Stachu1/Sodar/pictures/sodar_setup.png

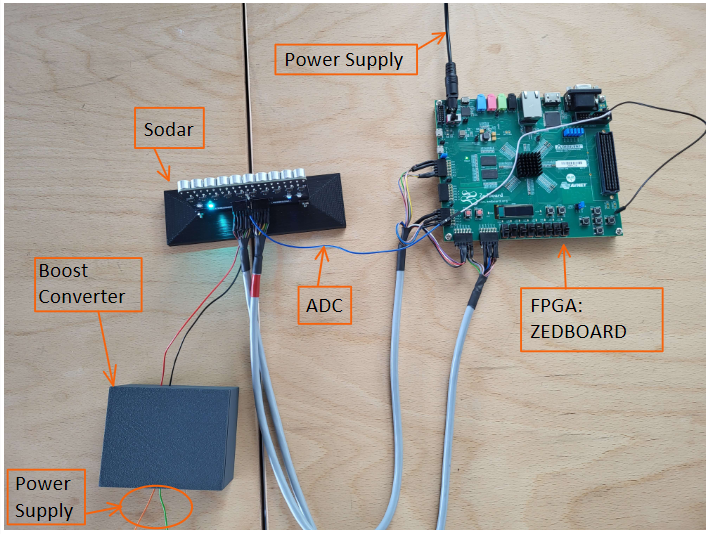
pictures/sodar_setup.png
