Stachu1/Sodar/simulations/pattern_3D.png

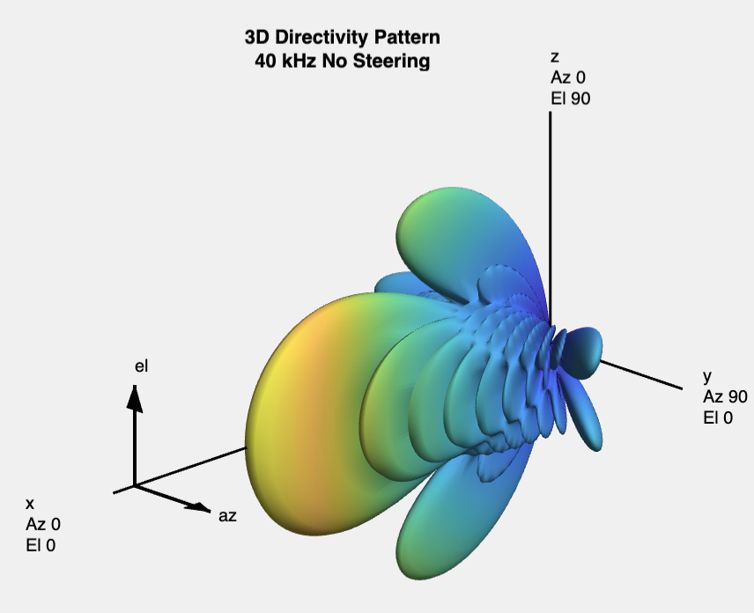
simulations/pattern_3D.png
