Stachu1/Sodar/pictures/Flow_chart_sodar.PNG

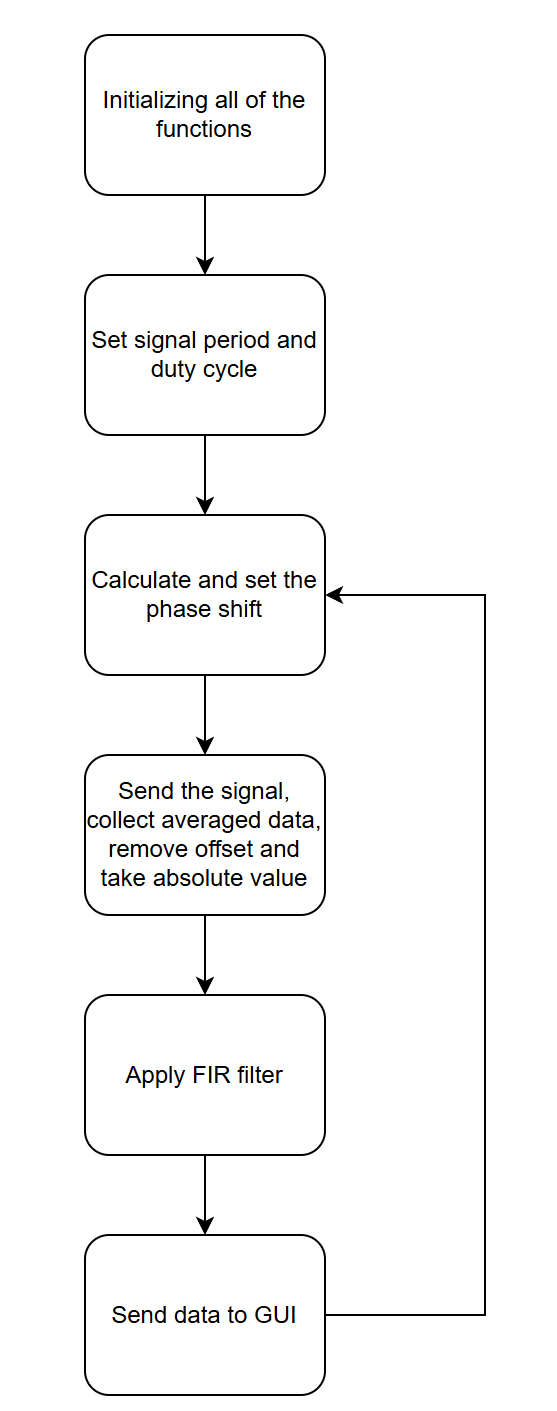
pictures/Flow_chart_sodar.PNG
