Stachu1/Sodar/pictures/PCB.png

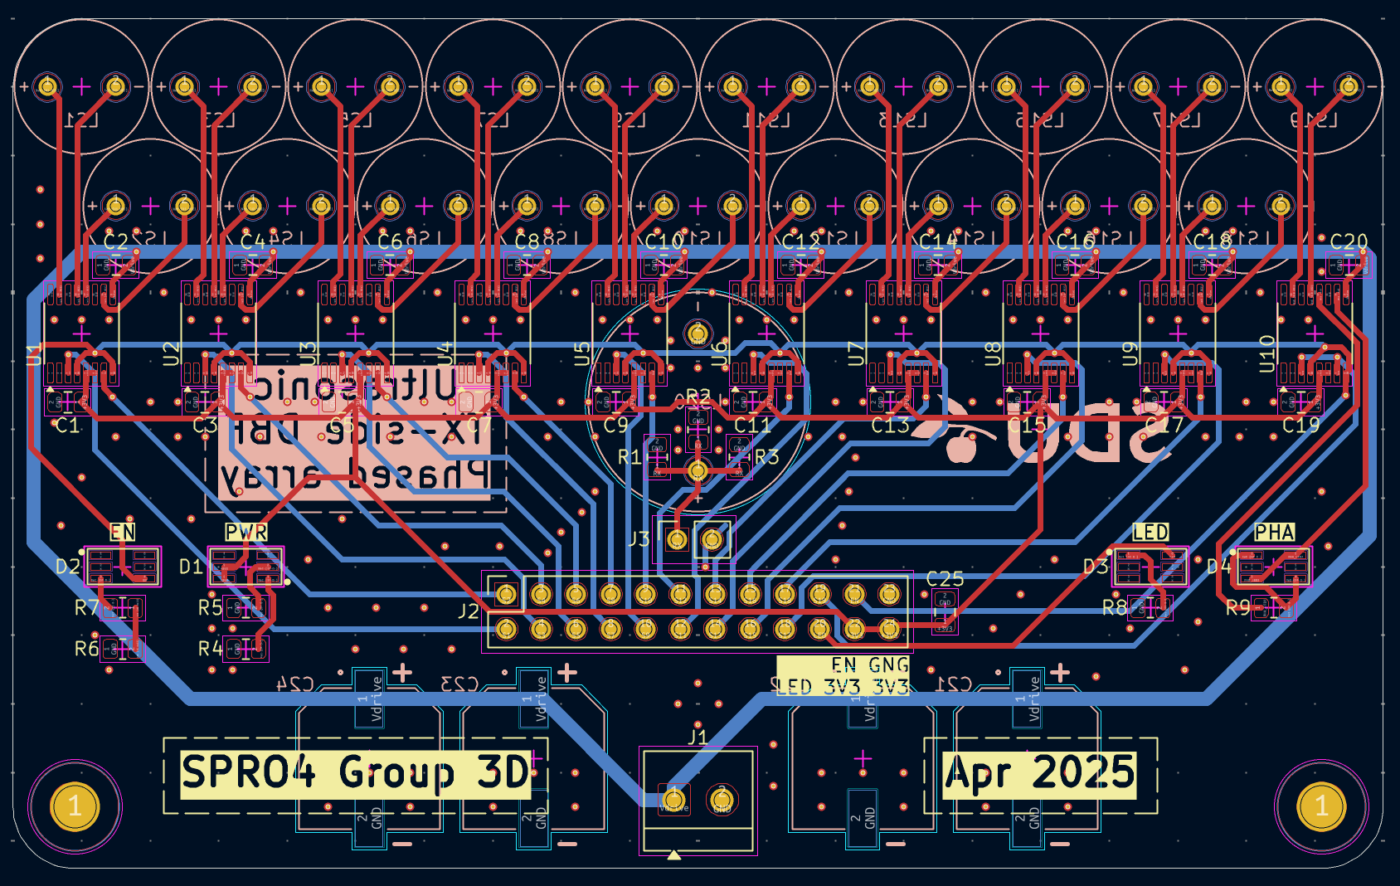
pictures/PCB.png
