Stachu1/Sodar/pictures/PCB_Sodar_schematic.PNG

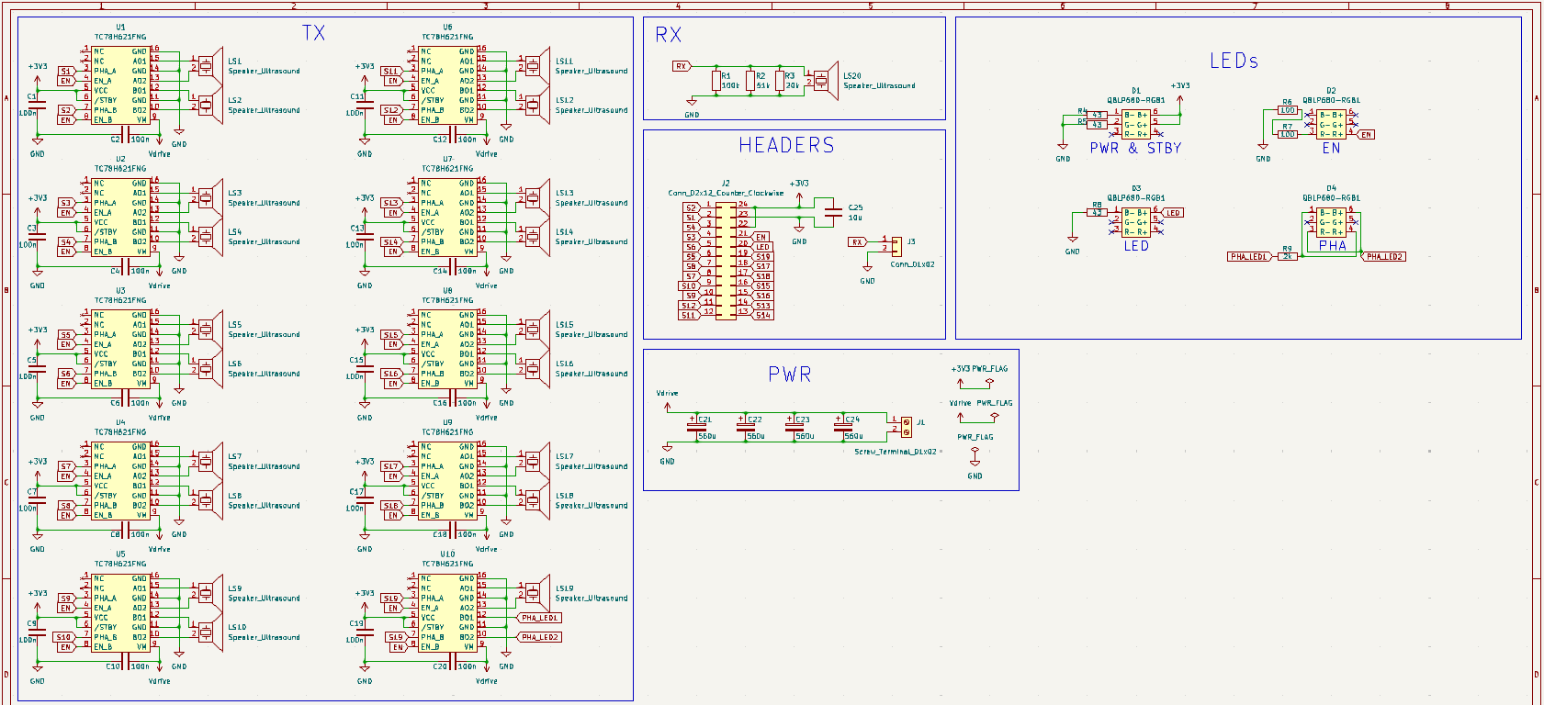
pictures/PCB_Sodar_schematic.PNG
