Stachu1/Sodar/pictures/Scan_distance.png

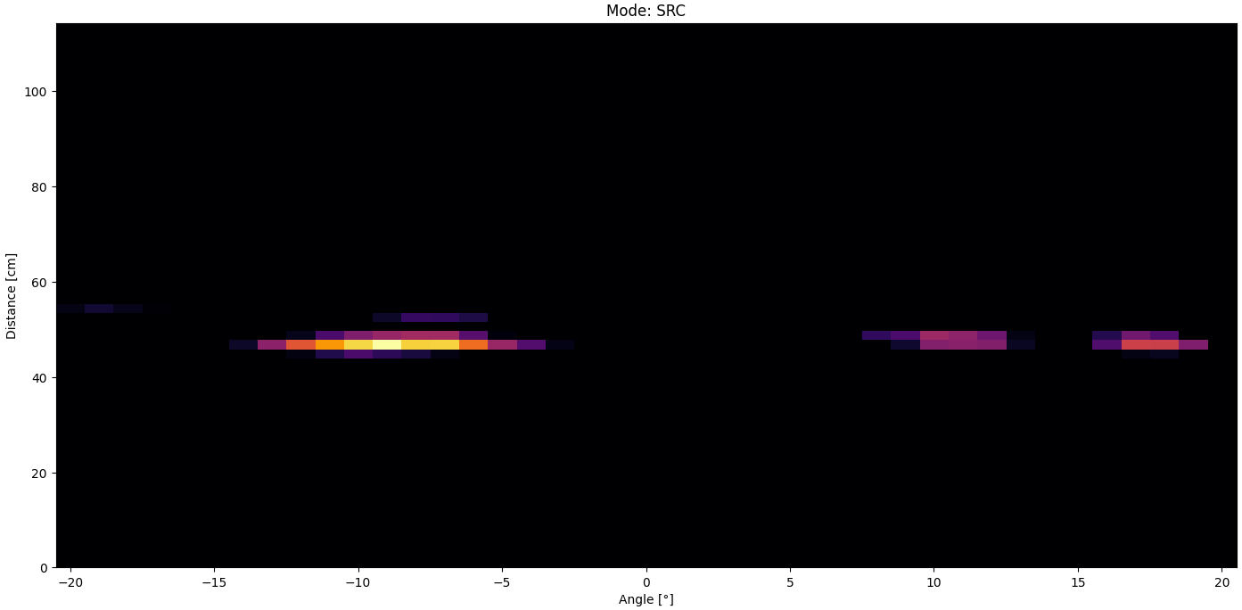
pictures/Scan_distance.png
