Stachu1/Sodar/pictures/Scan_early.png

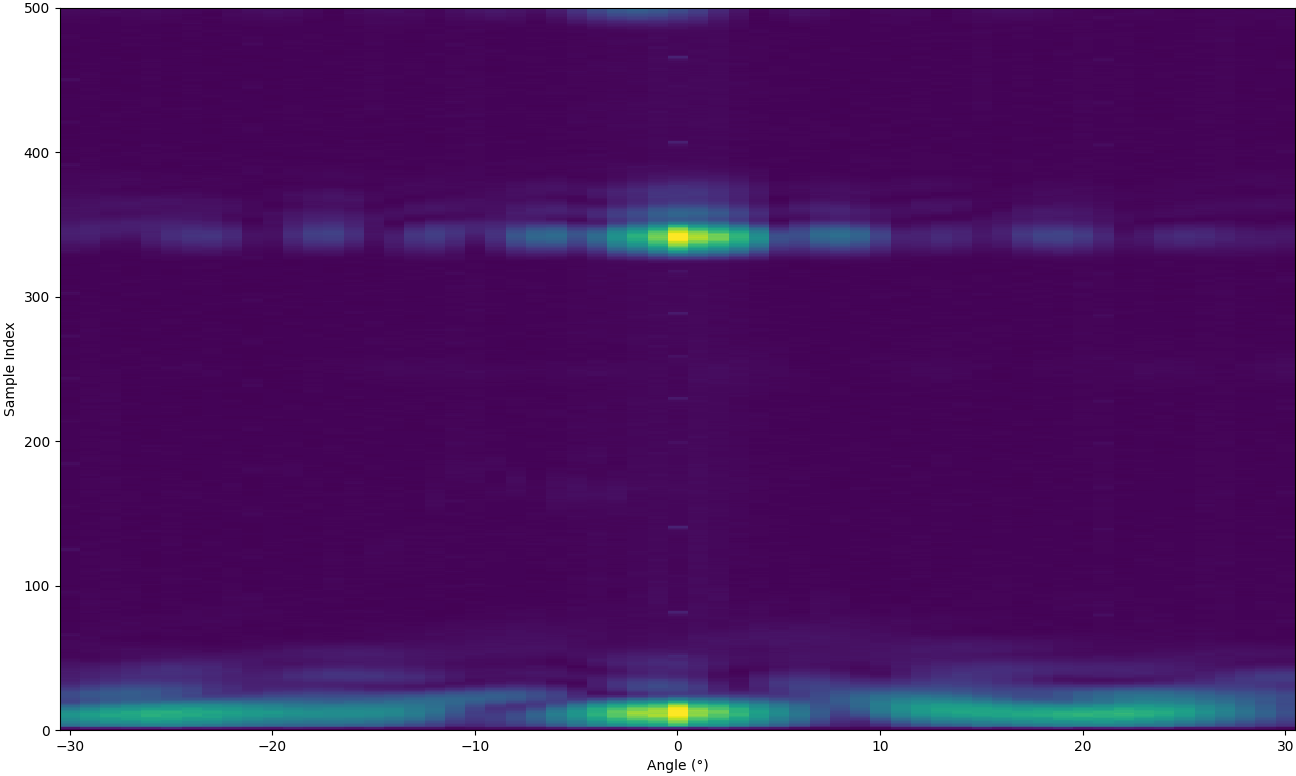
pictures/Scan_early.png
