Stachu1/Sodar/pictures/system_overview.png

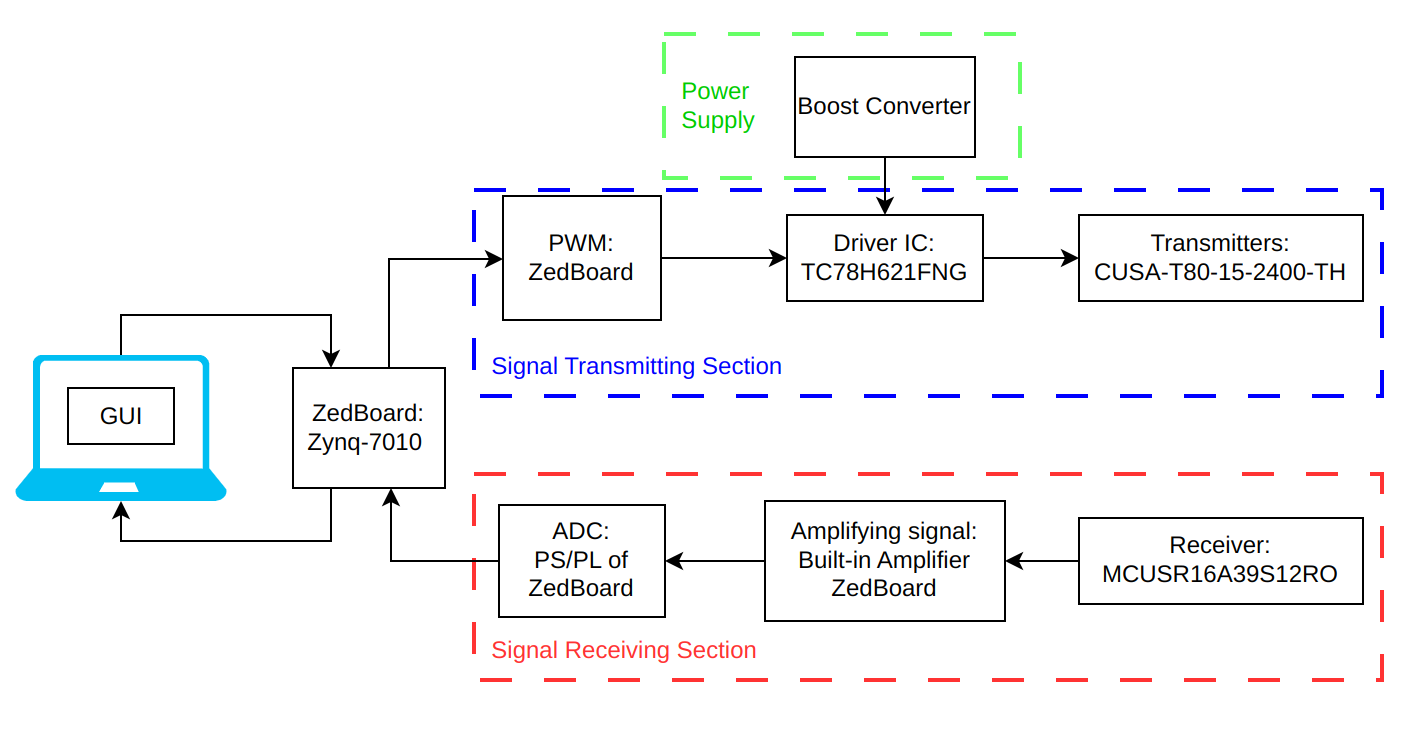
pictures/system_overview.png
