Stachu1/Sodar/simulations/25kHz_19_10mm.png

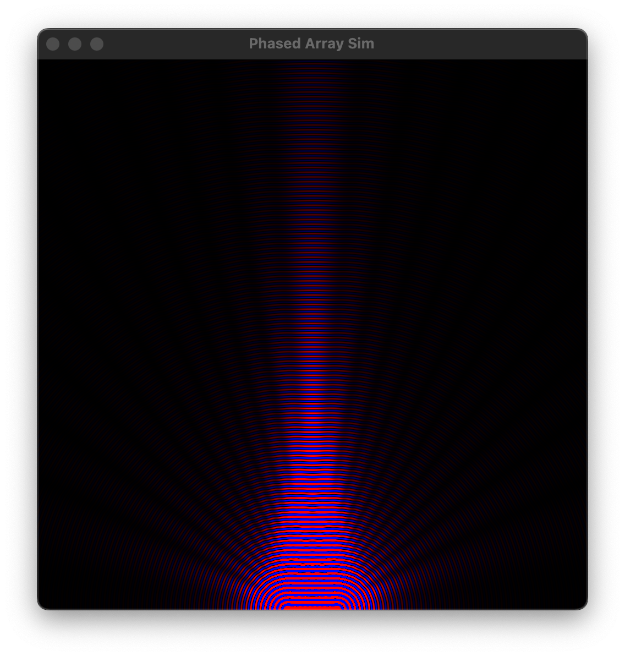
simulations/25kHz_19_10mm.png
