Stachu1/Sodar/simulations/array_pattern.png

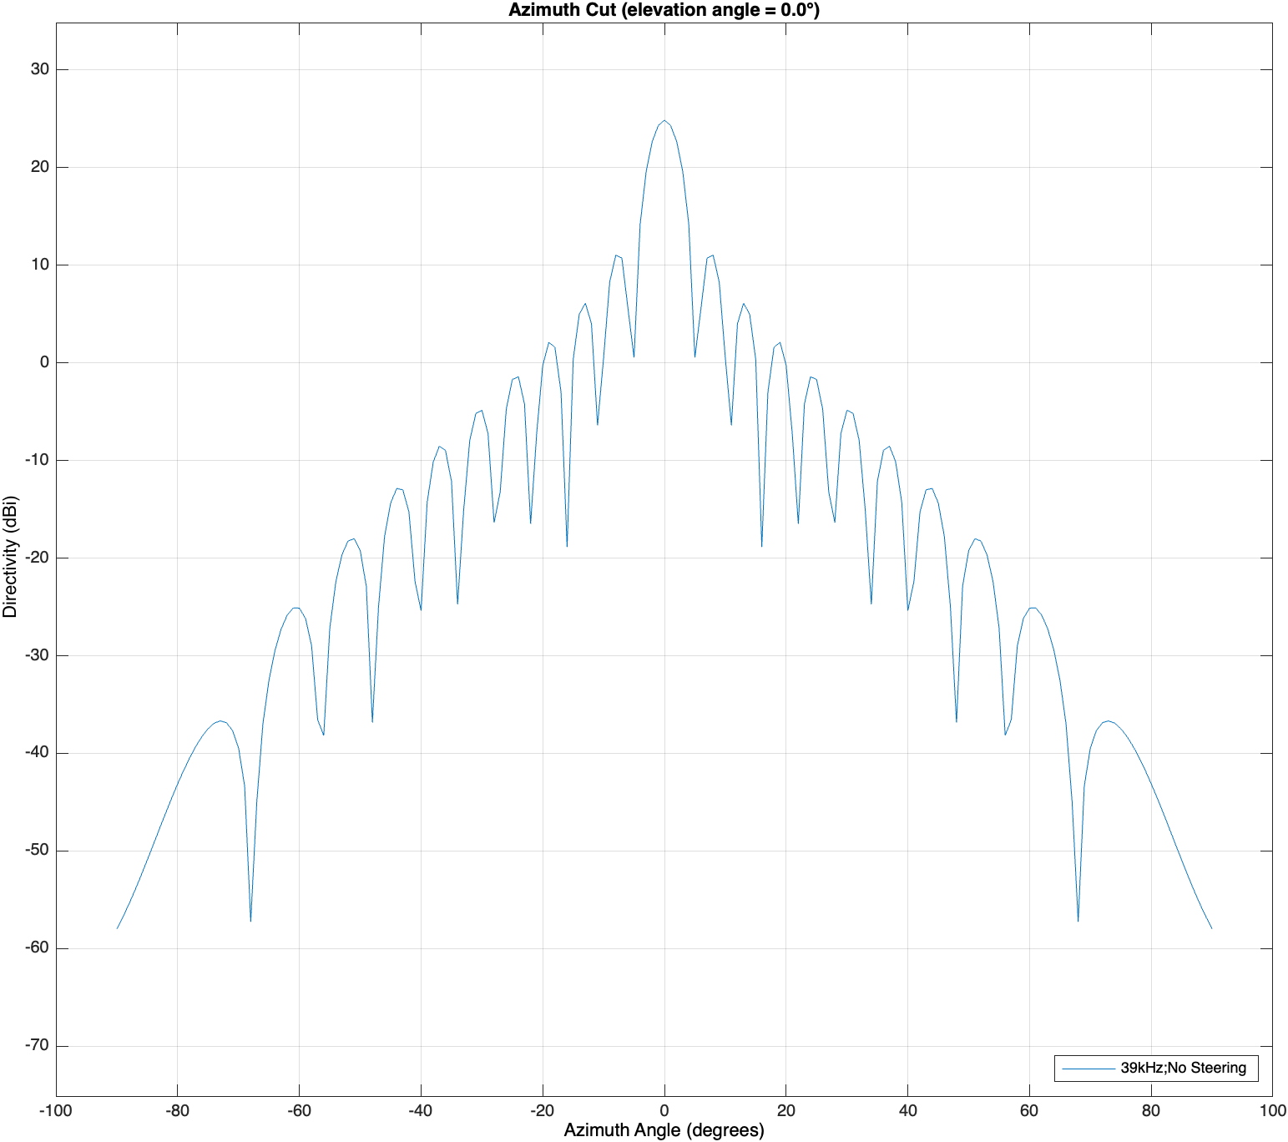
simulations/array_pattern.png
