Stachu1/Sodar/simulations/PL_side_block_design.png

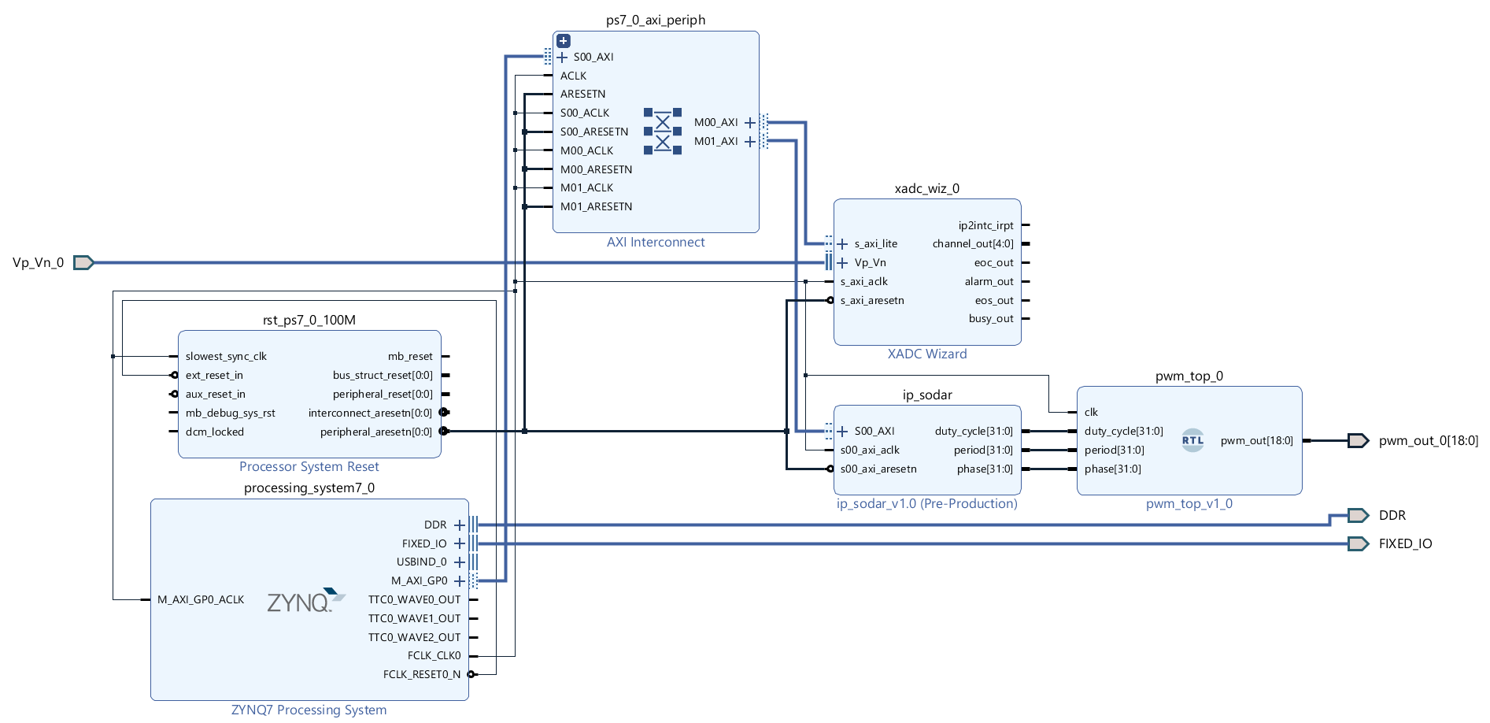
simulations/PL_side_block_design.png
