Stachu1/Sodar/simulations/Array_setup_matlab.png

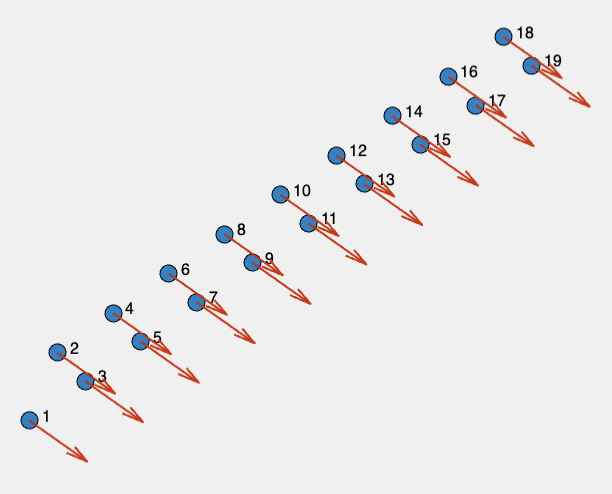
simulations/Array_setup_matlab.png
