Stachu1/Sodar/simulations/Filter_test_plot.png

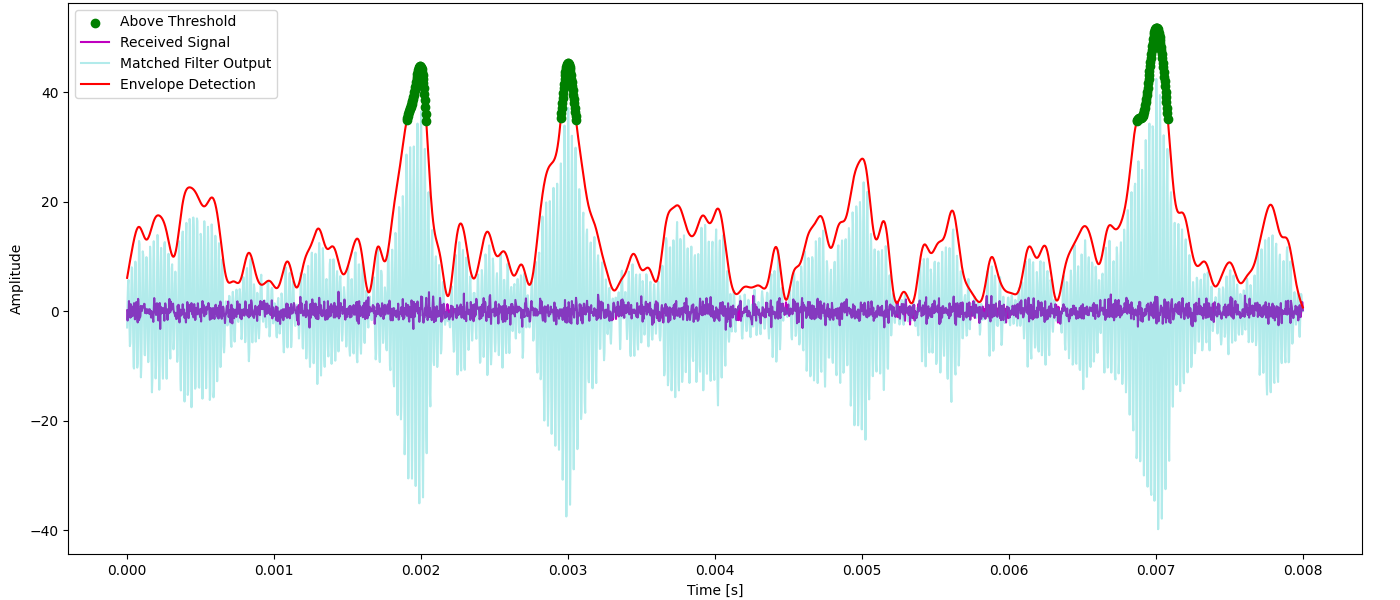
simulations/Filter_test_plot.png
