Stachu1/Sodar/PCB/sodar.kicad_pcb

## KiCad design PCB/sodar.kicad_pcb (2025-04-17)

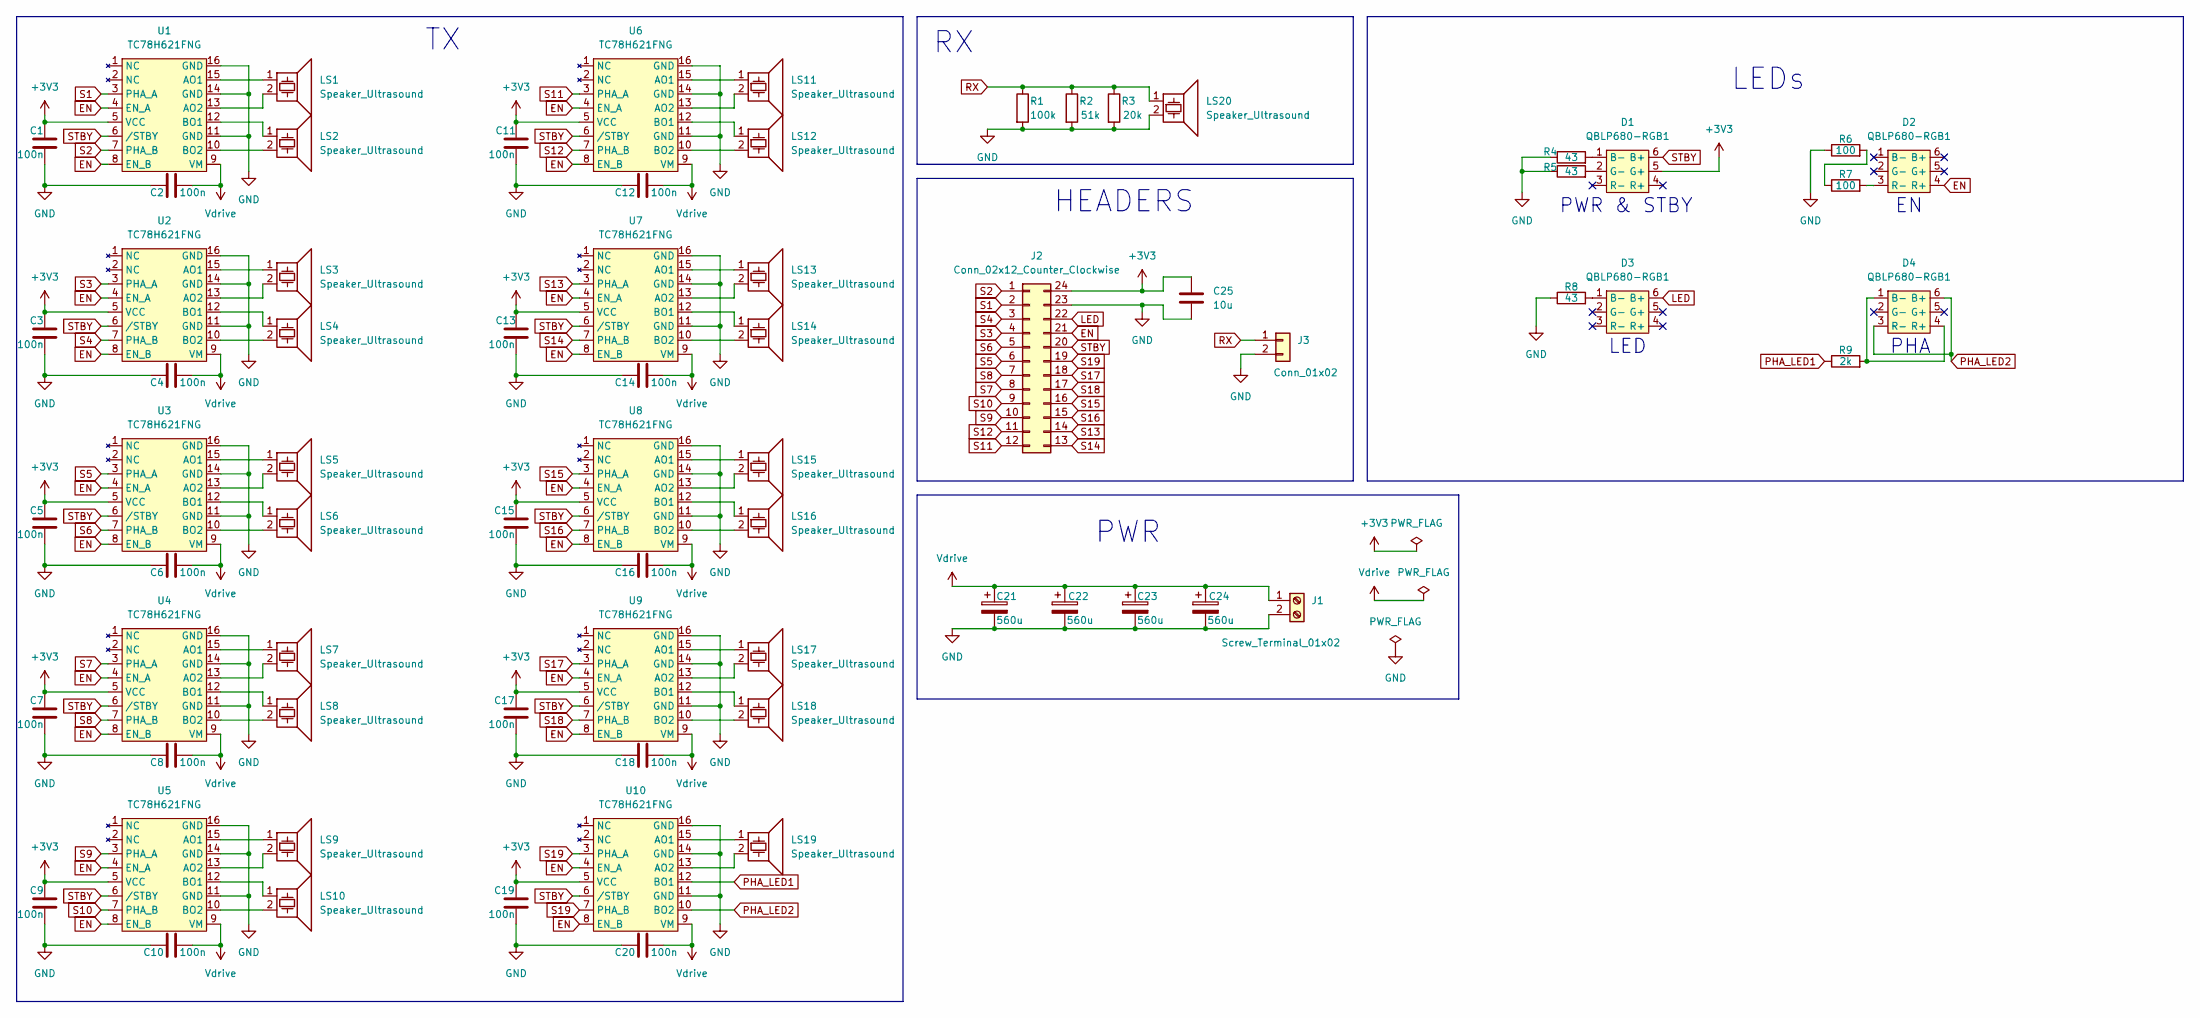
[picture p14: schematic sodar.kicad_sch]

Parts:
C1, C2, C3, C4, C5, C6, C7, C8, C9, C10, C11, C12, C13, C14, C15, C16, C17, C18, C19, C20: 100n; C_0805_2012Metric
C21, C22, C23, C24: 560u; CAP_EEEFT1V561AP
C25: 10u; C_0805_2012Metric
D1, D2, D3, D4: QBLP680-RGB1
J1: Screw_Terminal_01x02; TerminalBlock_4Ucon_1x02_P3.50mm_Horizontal
J2: Conn_02x12_Counter_Clockwise; PinSocket_2x12_P2.54mm_Vertical
J3: Conn_01x02; PinSocket_1x02_P2.54mm_Vertical
LS1, LS2, LS3, LS4, LS5, LS6, LS7, LS8, LS9, LS10, LS11, LS12, LS13, LS14, LS15, LS16, LS17, LS18, LS19: Speaker_Ultrasound; CUSA-T80-15-2400-TH
LS20: Speaker_Ultrasound; MCUSR16A39S12RO
R1: 100k; R_0805_2012Metric
R2: 51k; R_0805_2012Metric
R3: 20k; R_0805_2012Metric
R4, R5, R8: 43; R_0805_2012Metric
R6, R7: 100; R_0805_2012Metric
R9: 2k; R_0805_2012Metric
U1, U2, U3, U4, U5, U6, U7, U8, U9, U10: TC78H621FNG; TSSOP-16_4.4x5mm_P0.65mm

Connections:
EN: D2.4 (R+), J2.21, U1.4 (EN_A), U1.8 (EN_B), U2.4 (EN_A), U2.8 (EN_B), U3.4 (EN_A), U3.8 (EN_B), U4.4 (EN_A), U4.8 (EN_B), U5.4 (EN_A), U5.8 (EN_B), U6.4 (EN_A), U6.8 (EN_B), U7.4 (EN_A), U7.8 (EN_B), U8.4 (EN_A), U8.8 (EN_B), U9.4 (EN_A), U9.8 (EN_B), U10.4 (EN_A), U10.8 (EN_B)
GND: C1.2, C2.1, C3.2, C4.1, C5.2, C6.1, C7.2, C8.1, C9.2, C10.1, C11.2, C12.1, C13.2, C14.1, C15.2, C16.1, C17.2, C18.1, C19.2, C20.1, C21.2, C22.2, C23.2, C24.2, C25.2, J1.2, J2.23, J3.2, LS20.2, R1.2, R2.2, R3.2, R4.1, R5.1, R6.1, R8.1, U1.11 (GND), U1.14 (GND), U1.16 (GND), U2.11 (GND), U2.14 (GND), U2.16 (GND), U3.11 (GND), U3.14 (GND), U3.16 (GND), U4.11 (GND), U4.14 (GND), U4.16 (GND), U5.11 (GND), U5.14 (GND), U5.16 (GND), U6.11 (GND), U6.14 (GND), U6.16 (GND), U7.11 (GND), U7.14 (GND), U7.16 (GND), U8.11 (GND), U8.14 (GND), U8.16 (GND), U9.11 (GND), U9.14 (GND), U9.16 (GND), U10.11 (GND), U10.14 (GND), U10.16 (GND)
unnamed: D1.1 (B-), R4.2
unnamed: D1.2 (G-), R5.2
unnamed: D2.3 (R-), R7.2
unnamed: D3.1 (B-), R8.2
unnamed: D4.1 (B-), D4.4 (R+), R9.2
unnamed: R6.2, R7.1
unnamed: LS1.1, U1.15 (AO1)
unnamed: LS1.2, U1.13 (AO2)
unnamed: LS2.1, U1.12 (BO1)
unnamed: LS2.2, U1.10 (BO2)
unnamed: LS3.1, U2.15 (AO1)
unnamed: LS3.2, U2.13 (AO2)
unnamed: LS4.1, U2.12 (BO1)
unnamed: LS4.2, U2.10 (BO2)
unnamed: LS5.1, U3.15 (AO1)
unnamed: LS5.2, U3.13 (AO2)
unnamed: LS6.1, U3.12 (BO1)
unnamed: LS6.2, U3.10 (BO2)
unnamed: LS7.1, U4.15 (AO1)
unnamed: LS7.2, U4.13 (AO2)
unnamed: LS8.1, U4.12 (BO1)
unnamed: LS8.2, U4.10 (BO2)
unnamed: LS9.1, U5.15 (AO1)
unnamed: LS9.2, U5.13 (AO2)
unnamed: LS10.1, U5.12 (BO1)
unnamed: LS10.2, U5.10 (BO2)
unnamed: LS11.1, U6.15 (AO1)
unnamed: LS11.2, U6.13 (AO2)
unnamed: LS12.1, U6.12 (BO1)
unnamed: LS12.2, U6.10 (BO2)
unnamed: LS13.1, U7.15 (AO1)
unnamed: LS13.2, U7.13 (AO2)
unnamed: LS14.1, U7.12 (BO1)
unnamed: LS14.2, U7.10 (BO2)
unnamed: LS15.1, U8.15 (AO1)
unnamed: LS15.2, U8.13 (AO2)
unnamed: LS16.1, U8.12 (BO1)
unnamed: LS16.2, U8.10 (BO2)
unnamed: LS17.1, U9.15 (AO1)
unnamed: LS17.2, U9.13 (AO2)
unnamed: LS18.1, U9.12 (BO1)
unnamed: LS18.2, U9.10 (BO2)
unnamed: LS19.1, U10.15 (AO1)
unnamed: LS19.2, U10.13 (AO2)
PHA_LED1: R9.1, U10.12 (BO1)
PHA_LED2: D4.3 (R-), D4.6 (B+), U10.10 (BO2)
RX: J3.1, LS20.1, R1.1, R2.1, R3.1
S1: J2.2, U1.3 (PHA_A)
S2: J2.1, U1.7 (PHA_B)
S3: J2.4, U2.3 (PHA_A)
S4: J2.3, U2.7 (PHA_B)
S5: J2.6, U3.3 (PHA_A)
S6: J2.5, U3.7 (PHA_B)
S7: J2.8, U4.3 (PHA_A)
S8: J2.7, U4.7 (PHA_B)
S9: J2.10, U5.3 (PHA_A)
S10: J2.9, U5.7 (PHA_B)
S11: J2.12, U6.3 (PHA_A)
S12: J2.11, U6.7 (PHA_B)
S13: J2.14, U7.3 (PHA_A)
S14: J2.13, U7.7 (PHA_B)
S15: J2.16, U8.3 (PHA_A)
S16: J2.15, U8.7 (PHA_B)
S17: J2.18, U9.3 (PHA_A)
S18: J2.17, U9.7 (PHA_B)
S19: J2.19, U10.3 (PHA_A), U10.7 (PHA_B)
Vdrive: C2.2, C4.2, C6.2, C8.2, C10.2, C12.2, C14.2, C16.2, C18.2, C20.2, C21.1, C22.1, C23.1, C24.1, J1.1, U1.9 (VM), U2.9 (VM), U3.9 (VM), U4.9 (VM), U5.9 (VM), U6.9 (VM), U7.9 (VM), U8.9 (VM), U9.9 (VM), U10.9 (VM)

Notes on the sheet:
LEDs
PWR
LED
PWR & STBY
PHA
HEADERS

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
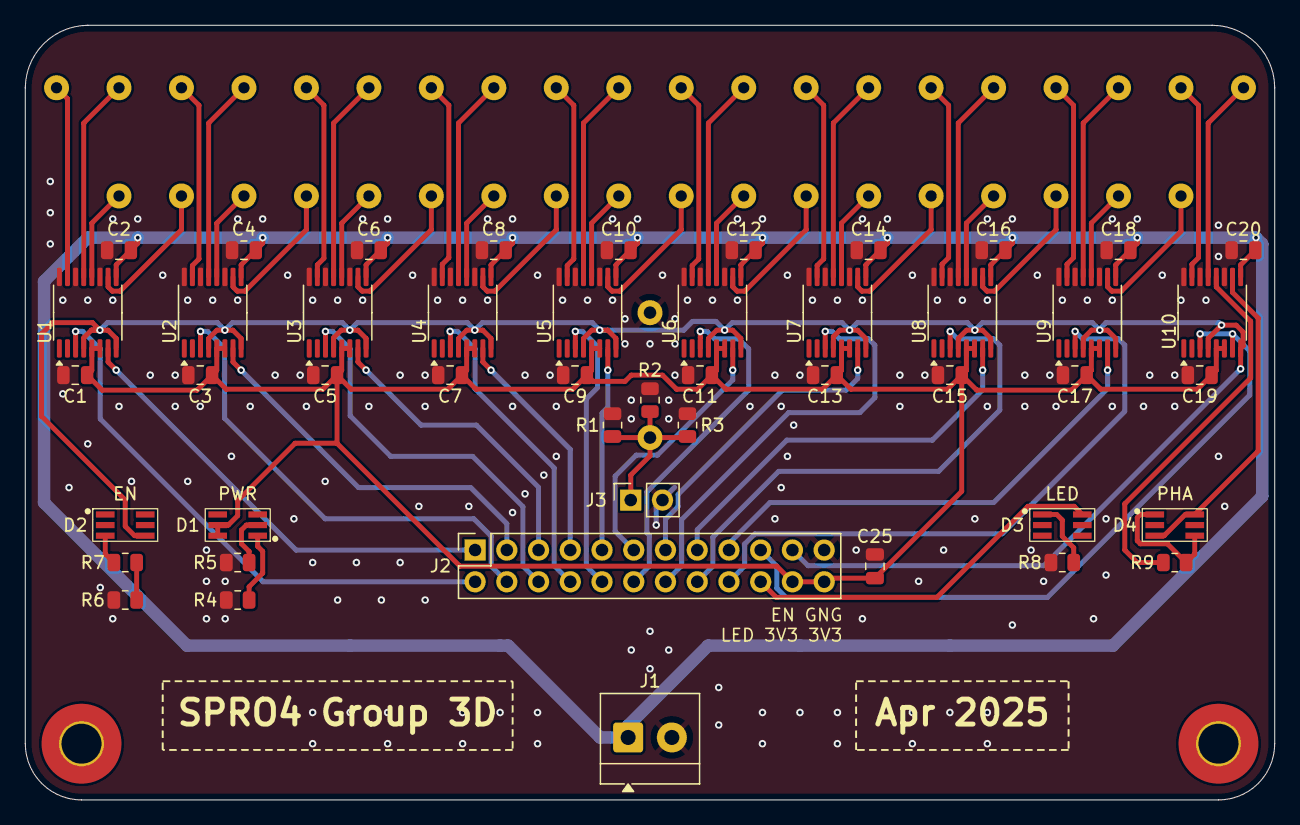
[picture p15: board sodar.kicad_pcb from above]

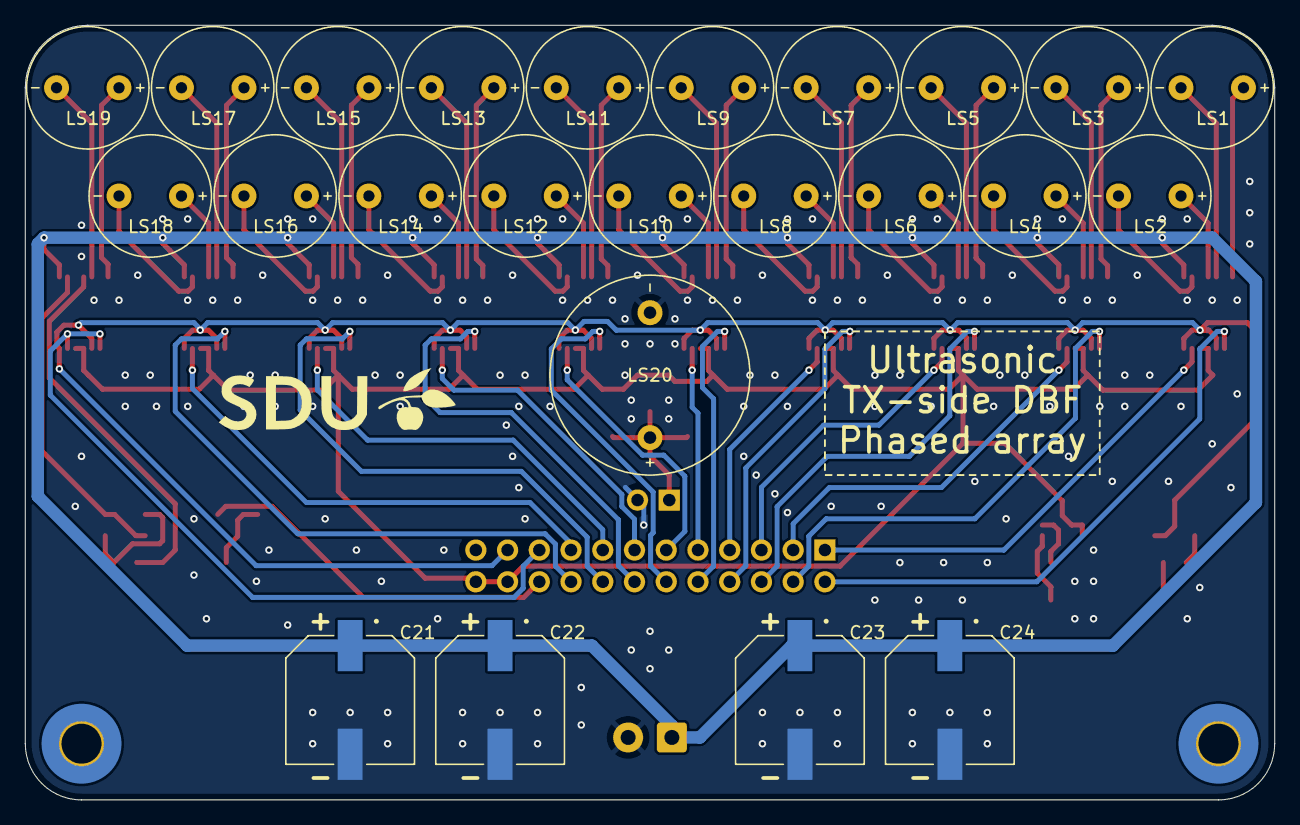
[picture p16: board sodar.kicad_pcb from below]

Board: 2 copper layers, 100.0 x 62.0 mm, 73 parts (24 on the bottom side), 71 nets.

Other parts of the board:
MountingHole1, MountingHole2: MountingHole_3.2mm_M3_Pad_TopBottom
