Stachu1/Sodar/(commit log)

2025-04-10 Added components footprints & symbols
    [project_pcb_4.kicad_pcb, project_pcb_4.kicad_sch]
2025-04-10 Renamed files
    [project.kicad_pcb, project.kicad_sch]
2025-04-10 Redo the project and added TC78H621FNG sym & footprint
    [project.kicad_pcb, project.kicad_sch, sodar.kicad_pcb, sodar.kicad_sch]
2025-04-10 Added Receiver & LED components
    [sodar.kicad_sch]
2025-04-10 Wired first driver-tansducer module
    [sodar.kicad_sch]
2025-04-11 Added the remaining drivers & transducer to the schematics
    [sodar.kicad_sch]
2025-04-11 Added new cap footprint
2025-04-11 Added capacitors to the drivers & Added receiver
    [sodar.kicad_sch]
2025-04-11 Added Pin header
    [sodar.kicad_sch]
2025-04-11 Added LEDs to the schematics - PWR EN STBY LED PHA
    [sodar.kicad_sch]
2025-04-11 Added Screw terminal & capacitors to the schematics
    [sodar.kicad_sch]
2025-04-11 Assigned footprints
    [sodar.kicad_sch]
2025-04-11 Fixed receiver schematics
    [sodar.kicad_sch]
2025-04-11 Updated transducers footprints - pad numbers & silkscreen
2025-04-11 Init PCB
    [sodar.kicad_pcb]
2025-04-13 Szymi pcb design (#5)
    * updated transmiter footprint
    * Moved the transducers and the drivers in the right positions
    * first PCB layout finished, to be reviewed
    ---------
    [sodar.kicad_pcb]
2025-04-13 Sodar plot for +/- 30 deg & 500 samples
2025-04-17 Moved driver ICs
    [sodar.kicad_pcb]
2025-04-17 Added a bulk cap on 3V3 line
    [sodar.kicad_sch]
2025-04-17 Better decoupling caps placement
    [sodar.kicad_pcb]
2025-04-17 Routed transducers and decoup caps to the ICs
    [sodar.kicad_pcb]
2025-04-17 Moved signal connections on the header for easier routing
    [sodar.kicad_pcb, sodar.kicad_sch]
2025-04-17 Routed signal lines from the headero to the driver ICs
    [sodar.kicad_pcb]
2025-04-17 Improved signal routing & routed receiver pull-down resistors
    [sodar.kicad_pcb]
2025-04-17 Movec components & connected STBY signal
    [sodar.kicad_pcb]
2025-04-17 Better STBY routing & Started to route EN
    [sodar.kicad_pcb]
2025-04-17 Routed EN
    [sodar.kicad_pcb]
2025-04-17 Moved the header 2mm lower so that there is space for the receiver
    [sodar.kicad_pcb]
2025-04-17 Rerouted STBY to 3V3 as we set it to 3V3 anyway
    [sodar.kicad_pcb, sodar.kicad_sch]
2025-04-17 Routed 3V3/STBY
    [sodar.kicad_pcb]
2025-04-17 Routed EN on the back for better caps routing
    [sodar.kicad_pcb]
2025-04-17 Routed VDrvie screw terminal & caps
    [sodar.kicad_pcb]
2025-04-17 Finished VDrive route & LEDs
    [sodar.kicad_pcb]
2025-04-17 PCB sphape changes & DRC fixes
    [sodar.kicad_pcb]
2025-04-17 Added moting holes and copper filed zone
    [sodar.kicad_pcb]
2025-04-17 DRC fixes & Stitching vias
    [sodar.kicad_pcb]
2025-04-17 Moved LEDs to the sides
    [sodar.kicad_pcb]
2025-04-17 Improved PHA signal routing
    [sodar.kicad_pcb]
2025-04-17 Anotehr routing improvement
    [sodar.kicad_pcb]
2025-04-17 Don't ignore footprint stuff in the DRC
2025-04-17 More vias
    [sodar.kicad_pcb]
2025-04-17 Added pin description & SPRO4 Group4 text
    [sodar.kicad_pcb]
2025-04-17 Added SDU logo to the footprints
2025-04-17 Added some silkscreen details
    [sodar.kicad_pcb]
2025-05-14 Ps firmware (#8)
    * Added ps side firmware
    * Updated scripts for faster baud rate
    * Added TRK mode but it's not working great
    * Changed FOV to 40deg & added auto scaling
    * Read data and plot in different threads for highier refresh rate
    * Added FOV macro & optimal transmit settings
    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
    [sodar_plot.py, sodar_ps.c]
2026-09-05 Revise README with detailed project information
    Updated project description, system overview, and components. Enhanced details on hardware, firmware, and signal processing. Added results and limitations of the ultrasonic phased array system.
